kms-synths/ESP_Friends/ESPF01 - oscilloscope/BOM-01.md

### BOM:

**Resistors:**
- 5.1k   x1
- 10k    x3 _(not necessary)_
- 43k    x1
- 100k   x3 
- 330k   x1
- 5k trimpot x1

**Capacitors:**
- 100pF  x1 _(not necessary)_
- 2n2    x1 _(not necessary)_
- 22nF   x1 _(not necessary)_
- 100nF  x2
- 220uF  x1 (I have noisy PSU so I placed 680uF)

**Other:**
- BAT54S                     x1
- MCP6002                    x1 or less noisy 0-6V op-amp _(it can be single-channel if you do not implement an LPF)_
- ESP32C3 Super Mini         x1
- OLED Screen SSD1306 128x64 x1
- Buttons                    x4
- Jacks                      x2
- Jumper                     x1 (for calibration)
- PinHeaders                 1\*08 x1 (or IDC-16), 1\*02 x5
