kms-synths/ESP_Friends/ESPF01 - oscilloscope/ESPF01-schematic.pdf

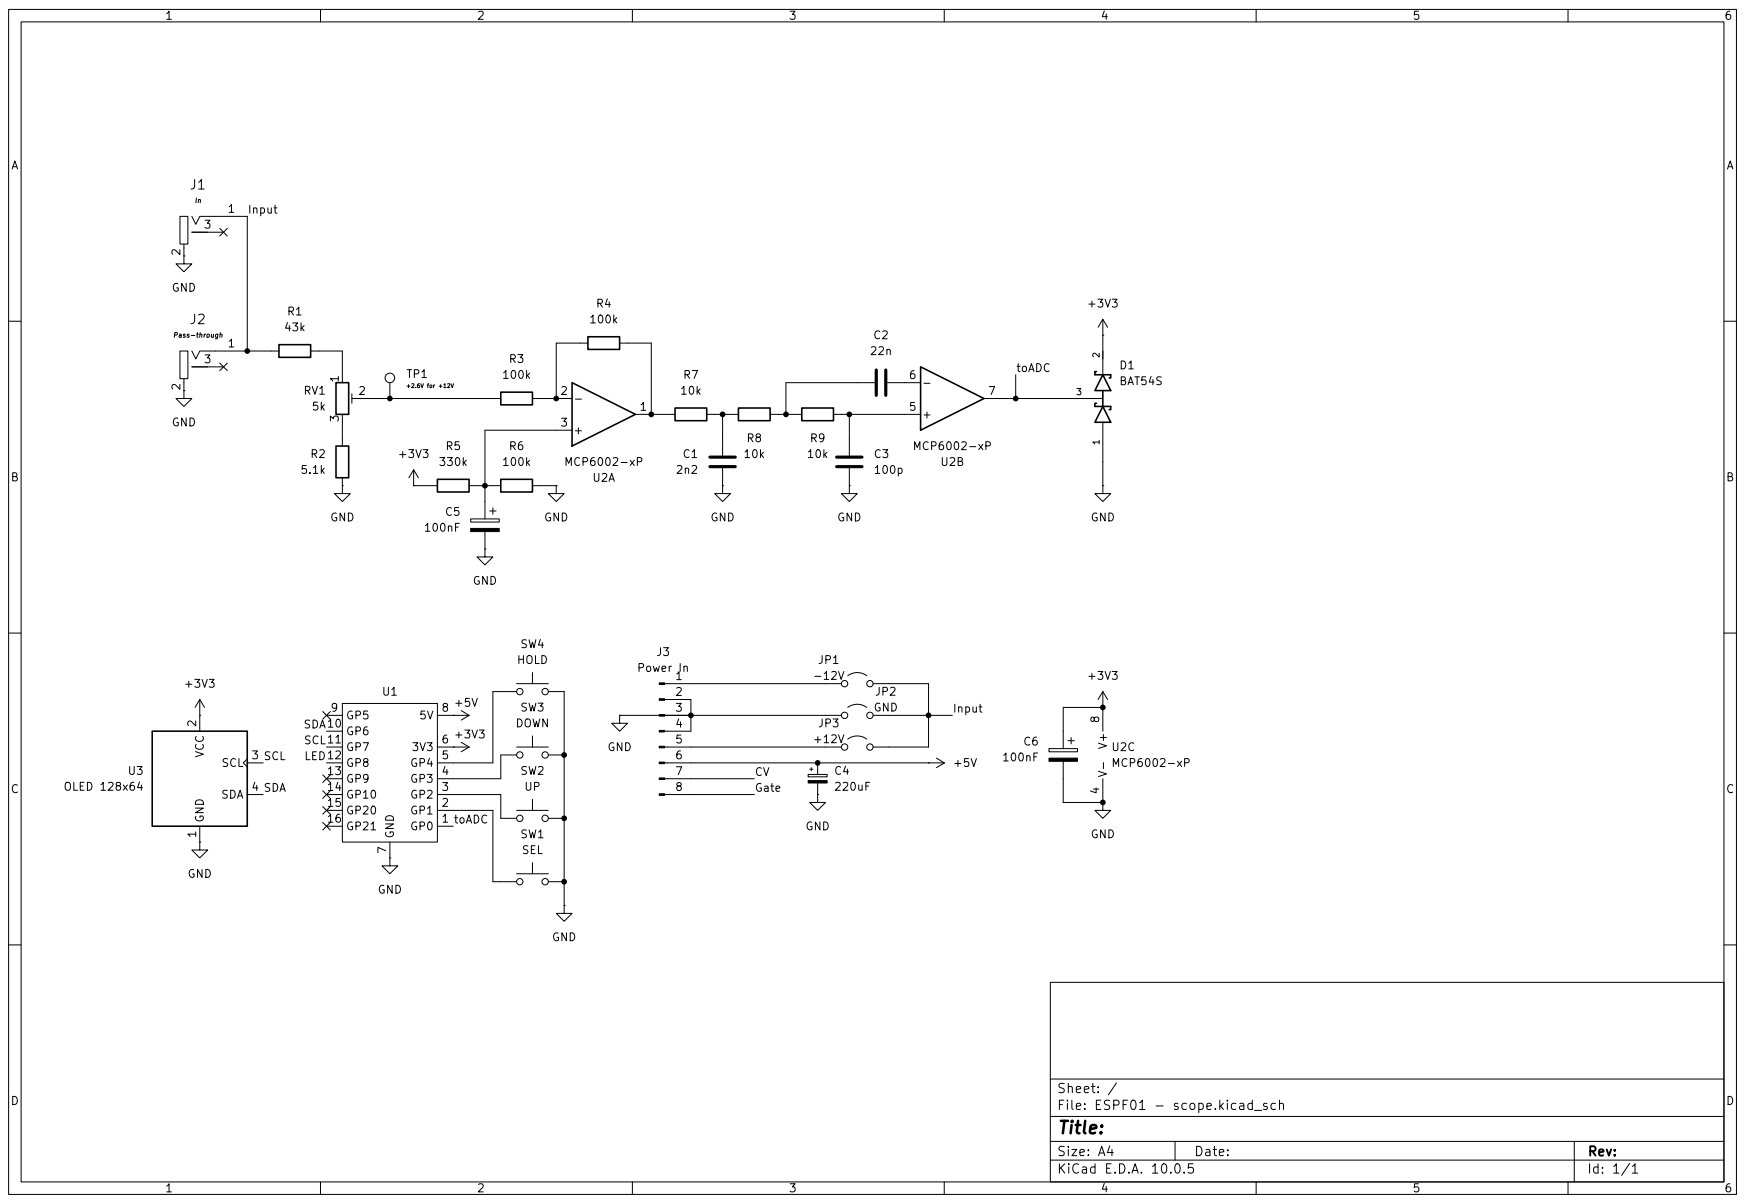
[picture p1: page 1]
